Penguin-Lab/cherry/parts/CHERRY_BODY_DOWN.STL

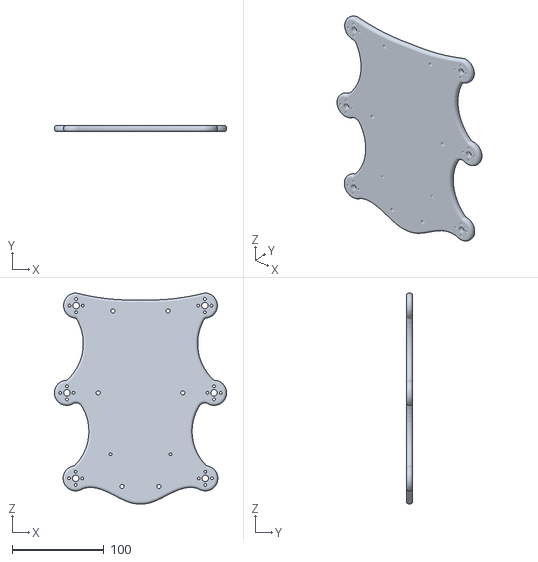
[picture p16: CAD file, 2026-10-26]
parts/CHERRY_BODY_DOWN.STL
187.3 x 7.00 x 229.5
