Penguin-Lab/cherry/parts/CHERRY_FEMUR_BACK_LEFT.STL

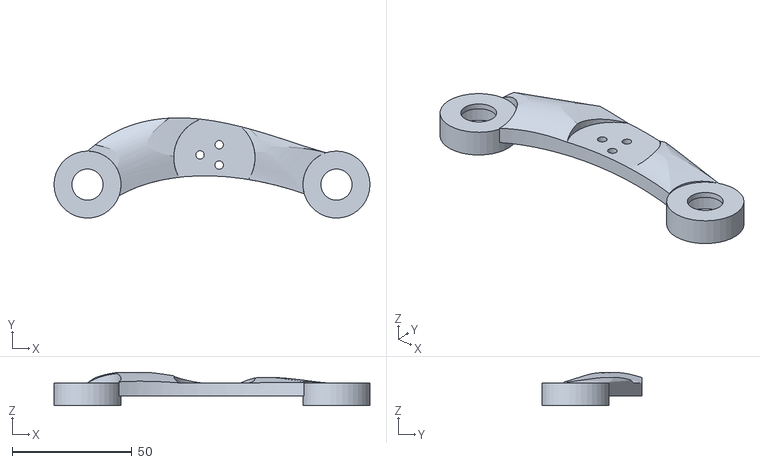
[picture p17: CAD file, 2026-10-26]
parts/CHERRY_FEMUR_BACK_LEFT.STL
132.0 x 41.9 x 13.8
