Penguin-Lab/cherry/parts/CHERRY_BODY_UP.STL

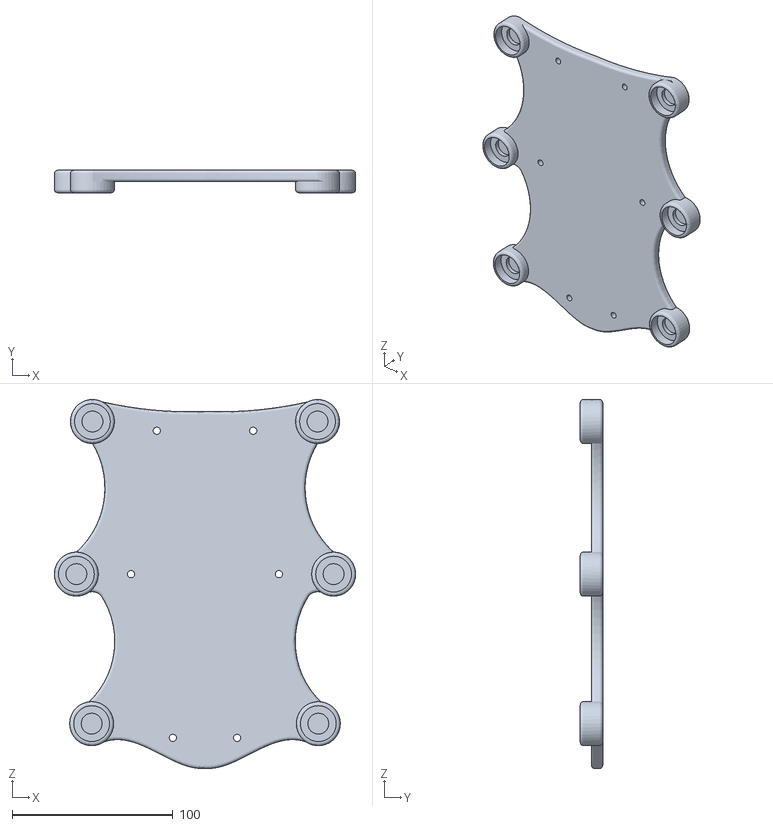
[picture p18: CAD file, 2026-10-26]
parts/CHERRY_BODY_UP.STL
187.4 x 14.0 x 229.5
