Penguin-Lab/cherry/parts/CHERRY_SPACER_CENTER.STL

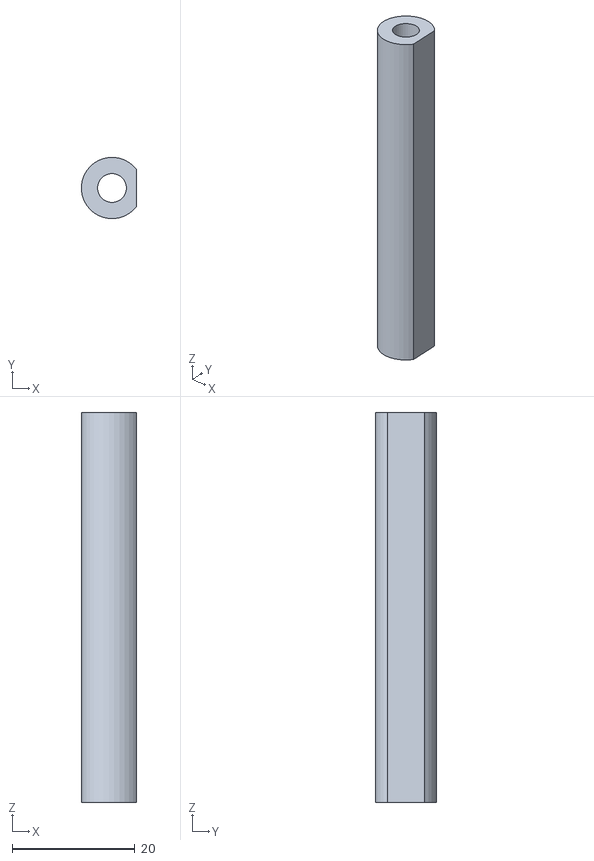
[picture p19: CAD file, 2026-10-26]
parts/CHERRY_SPACER_CENTER.STL
8.98 x 9.98 x 63.6
