Penguin-Lab/cherry/parts/CHERRY_OMBRO_UP_LEFT.STL

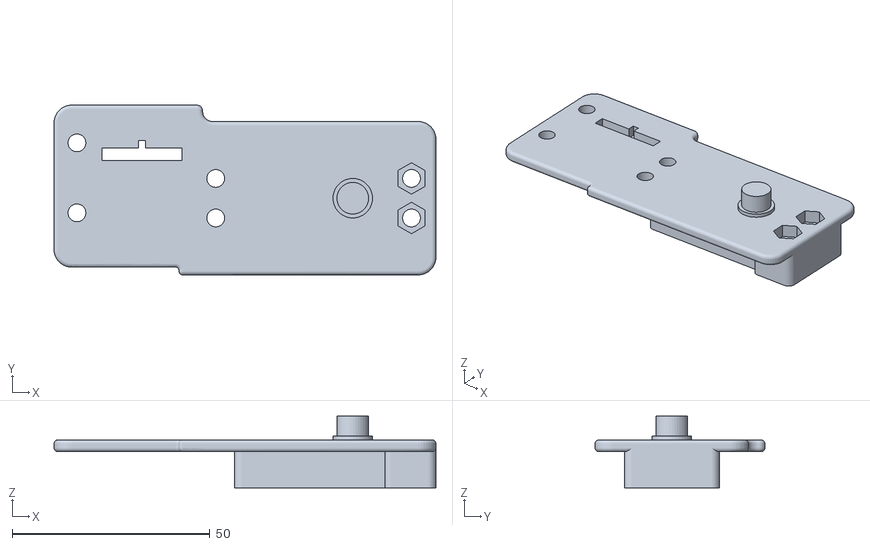
[picture p20: CAD file, 2026-10-26]
parts/CHERRY_OMBRO_UP_LEFT.STL
96.6 x 42.9 x 18.1
