Penguin-Lab/cherry/parts/CHERRY_BODY_UP_LEAVES.STL

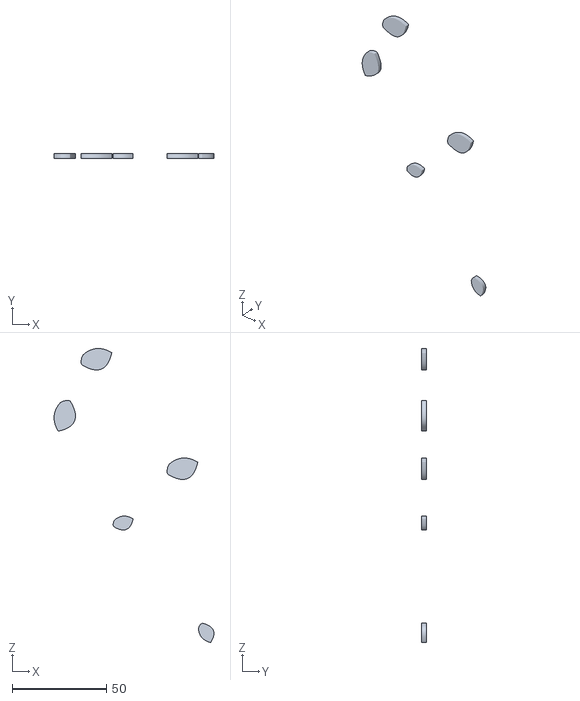
[picture p21: CAD file, 2026-10-26]
parts/CHERRY_BODY_UP_LEAVES.STL
84.8 x 2.50 x 155.8
