Penguin-Lab/cherry/parts/CHERRY_OMBRO_DOWN.STL

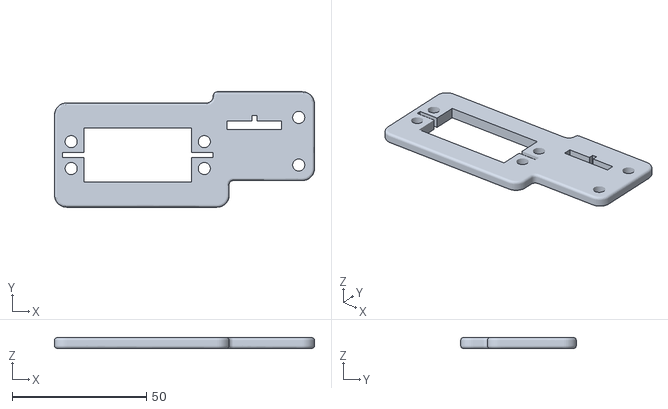
[picture p22: CAD file, 2026-10-26]
parts/CHERRY_OMBRO_DOWN.STL
96.7 x 43.0 x 4.00
