Penguin-Lab/cherry/parts/CHERRY_TIBIA_LEFT.STL

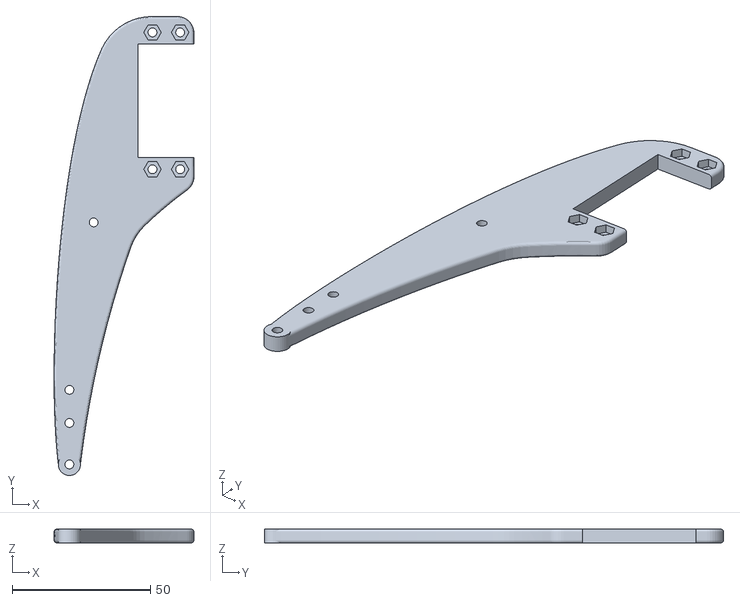
[picture p23: CAD file, 2026-10-26]
parts/CHERRY_TIBIA_LEFT.STL
50.6 x 166.0 x 5.00
