Penguin-Lab/cherry/parts/CHERRY_FEMUR_FRONT_LEFT.STL

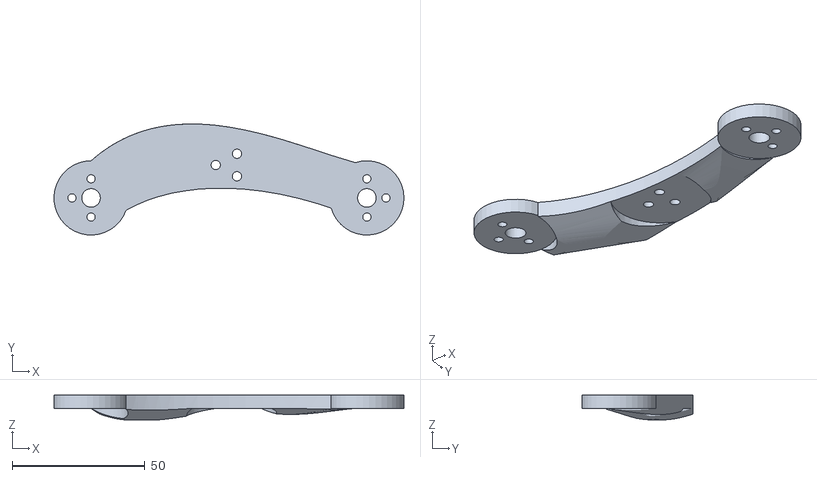
[picture p24: CAD file, 2026-10-26]
parts/CHERRY_FEMUR_FRONT_LEFT.STL
132.0 x 41.9 x 9.34
