Penguin-Lab/cherry/parts/CHERRY_FOOT.STL

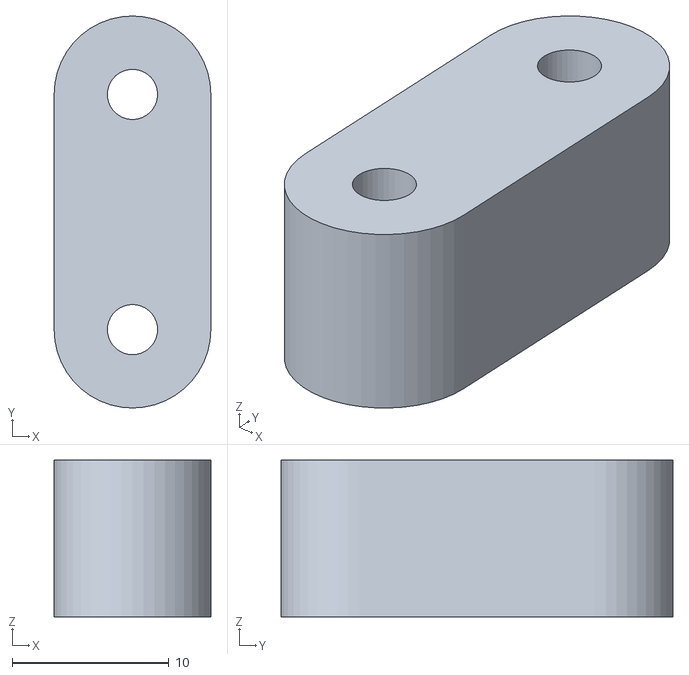
[picture p25: CAD file, 2026-10-26]
parts/CHERRY_FOOT.STL
10.0 x 25.0 x 10.0
