Penguin-Lab/cherry/parts/CHERRY_BODY_UP_BLOSSOMS.STL

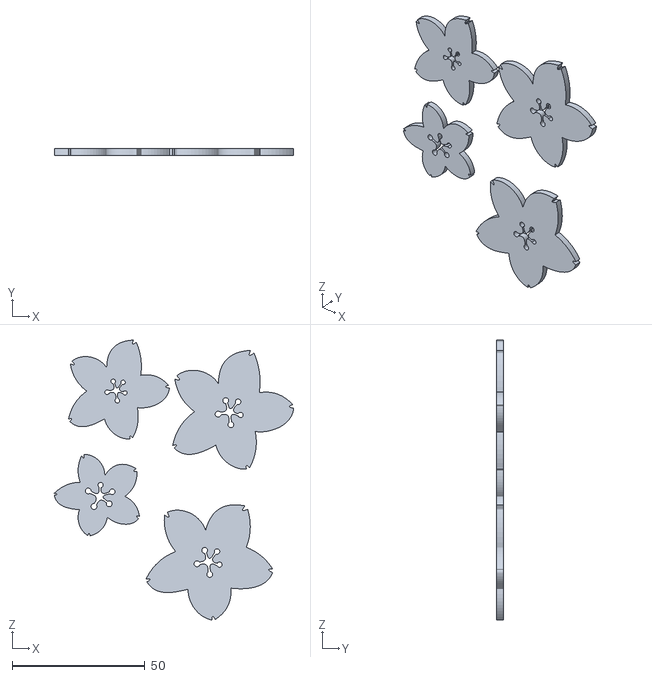
[picture p26: CAD file, 2026-10-26]
parts/CHERRY_BODY_UP_BLOSSOMS.STL
90.2 x 2.50 x 105.5
