Penguin-Lab/cherry/parts/CHERRY_BATTERY_DOOR.STL

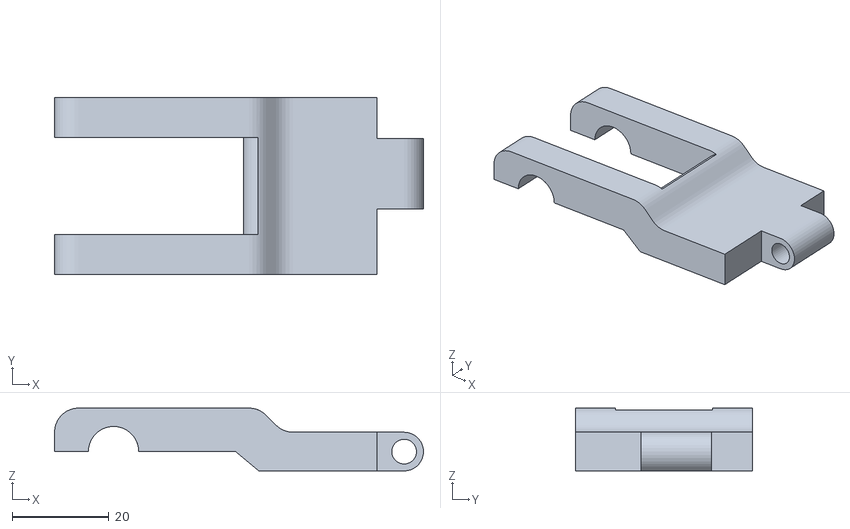
[picture p27: CAD file, 2026-10-26]
parts/CHERRY_BATTERY_DOOR.STL
76.2 x 36.6 x 13.0
