Penguin-Lab/cherry/parts/CHERRY_SHIELD_B_RIGHT.STL

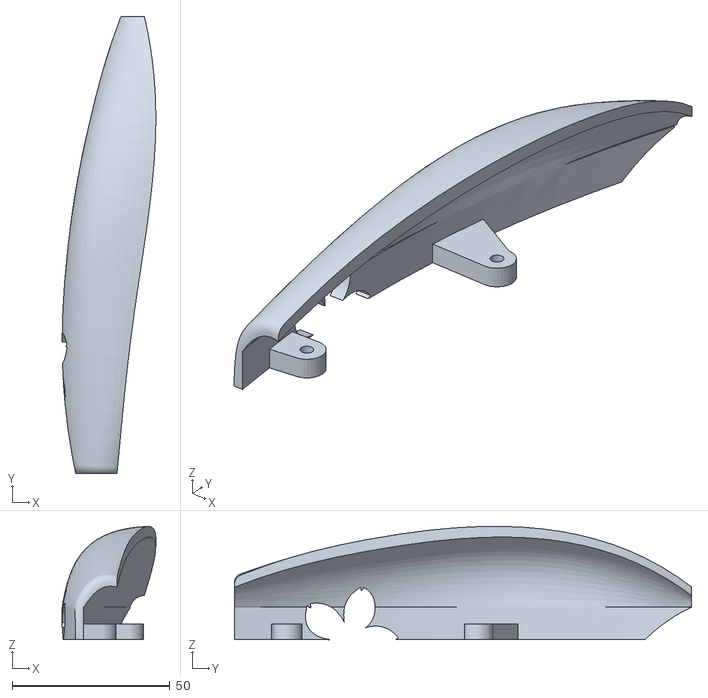
[picture p28: CAD file, 2026-10-26]
parts/CHERRY_SHIELD_B_RIGHT.STL
29.7 x 145.0 x 35.9
