Penguin-Lab/cherry/parts/CHERRY_BODY_UP_BRANCH.STL

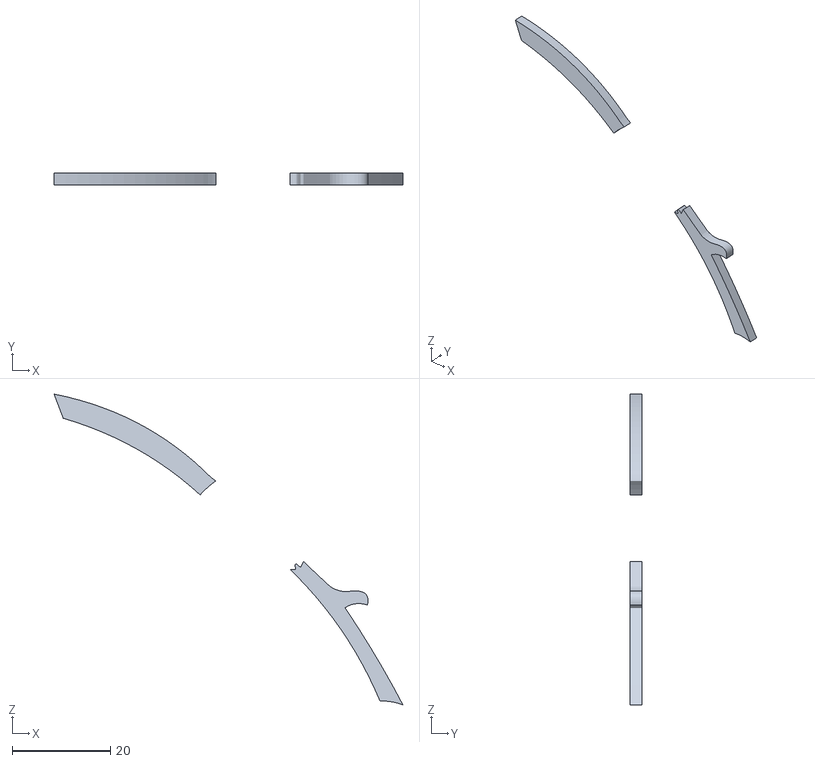
[picture p29: CAD file, 2026-10-26]
parts/CHERRY_BODY_UP_BRANCH.STL
71.1 x 2.50 x 63.4
