Penguin-Lab/cherry/parts/CHERRY_BATTERY_CASE.STL

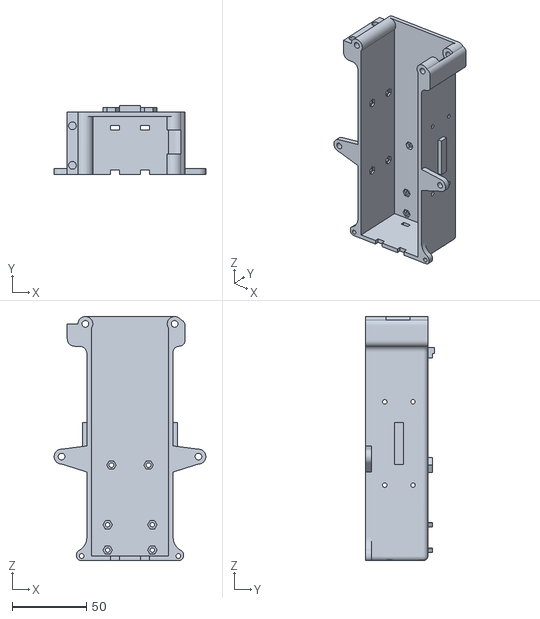
[picture p30: CAD file, 2026-10-26]
parts/CHERRY_BATTERY_CASE.STL
102.0 x 46.5 x 164.0
