Penguin-Lab/cherry/parts/CHERRY_SUPORT_PLUGS_SWITCHES.STL

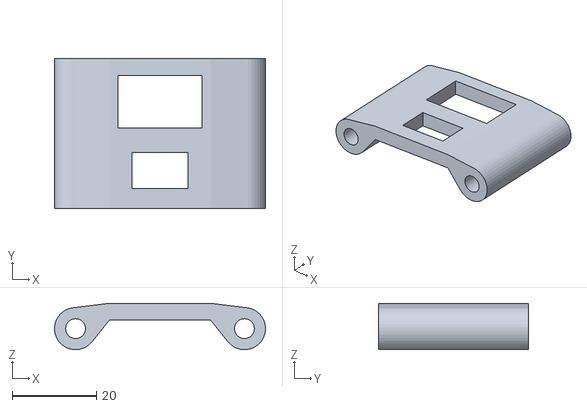
[picture p31: CAD file, 2026-10-26]
parts/CHERRY_SUPORT_PLUGS_SWITCHES.STL
50.0 x 35.5 x 11.0
