Penguin-Lab/cherry/parts/CHERRY_TAMPA_MOTOR_DS3230.STL

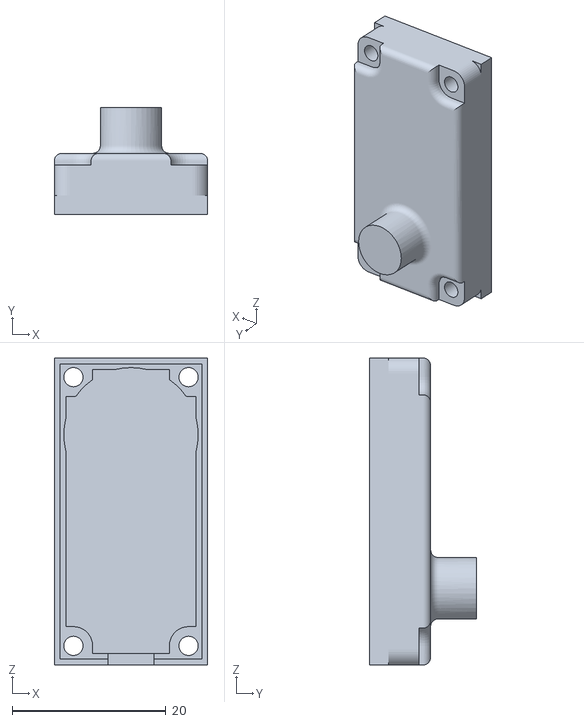
[picture p32: CAD file, 2026-10-26]
parts/CHERRY_TAMPA_MOTOR_DS3230.STL
20.0 x 14.0 x 40.0
