Penguin-Lab/cherry/parts/CHERRY_FEMUR_MIDDLE.STL

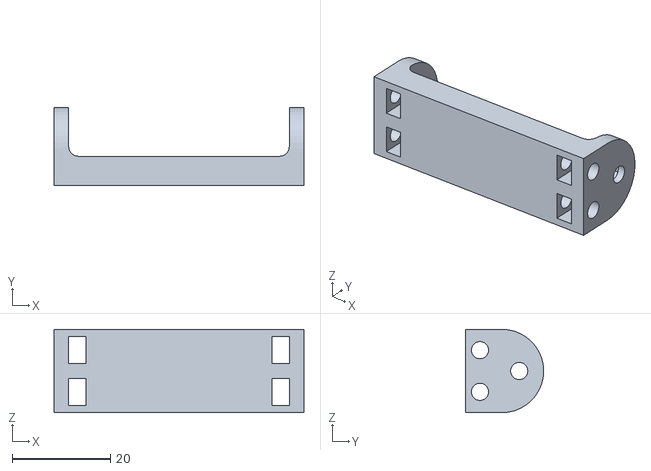
[picture p33: CAD file, 2026-10-26]
parts/CHERRY_FEMUR_MIDDLE.STL
51.0 x 16.0 x 17.0
