Penguin-Lab/cherry/parts/CHERRY_TIBIA_MIDDLE.STL

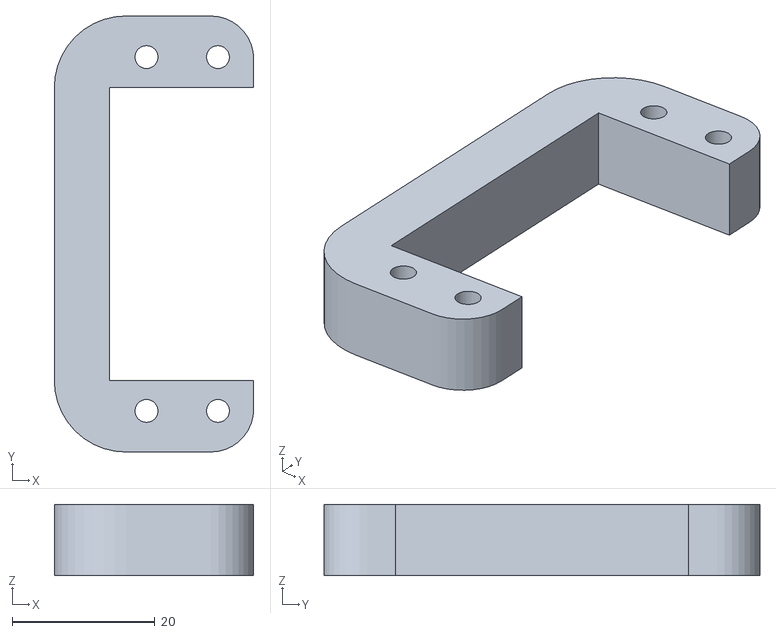
[picture p34: CAD file, 2026-10-26]
parts/CHERRY_TIBIA_MIDDLE.STL
27.9 x 61.0 x 10.0
