Penguin-Lab/cherry/parts/CHERRY_SPACER_FRONT.STL

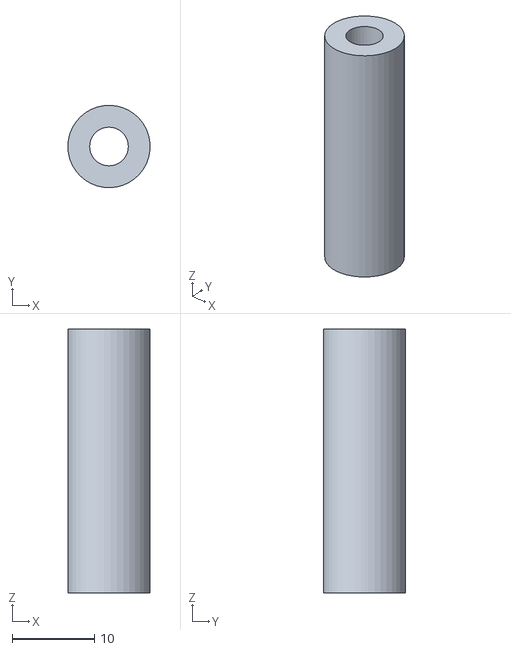
[picture p35: CAD file, 2026-10-26]
parts/CHERRY_SPACER_FRONT.STL
10.0 x 9.99 x 32.0
