Penguin-Lab/cherry/parts/CHERRY_LOGO.STL

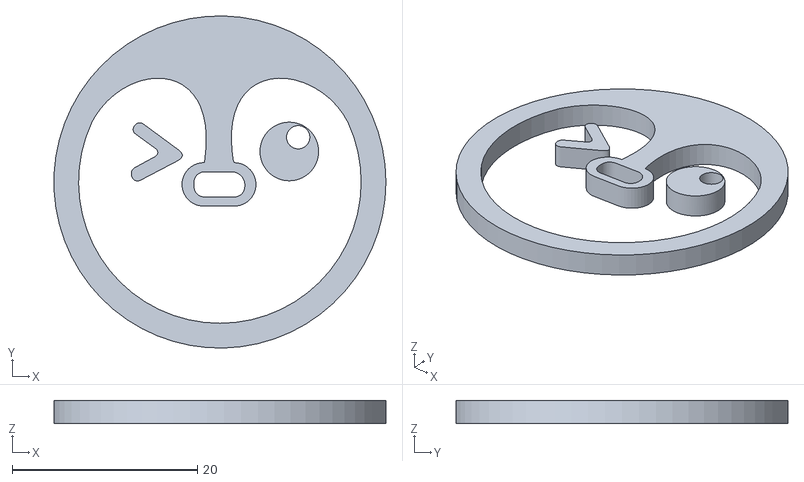
[picture p36: CAD file, 2026-10-26]
parts/CHERRY_LOGO.STL
35.9 x 35.9 x 2.50
