Penguin-Lab/cherry/parts/CHERRY_SUPORT_PLUGS_BATTERY.STL

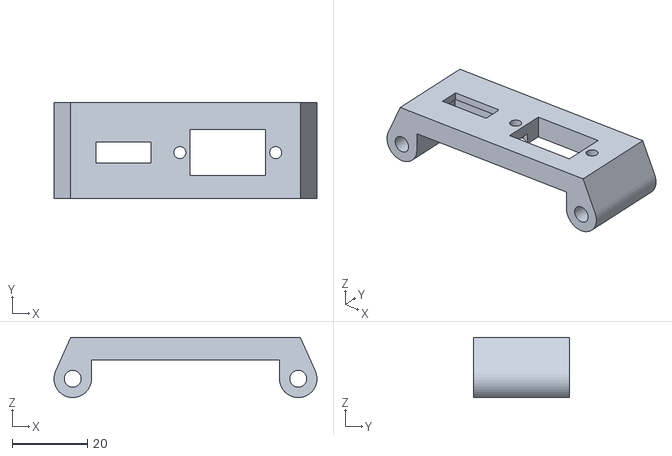
[picture p37: CAD file, 2026-10-26]
parts/CHERRY_SUPORT_PLUGS_BATTERY.STL
70.0 x 25.6 x 16.0
