Penguin-Lab/cherry/(list of files, cad)

Other CAD files:
parts/CHERRY_FEMUR_BACK_RIGHT.STL
parts/CHERRY_FEMUR_FRONT_RIGHT.STL
parts/CHERRY_SHIELD_A_LEFT.STL
parts/CHERRY_TIBIA_RIGHT.STL
parts/CHERRY_SHIELD_B_LEFT.STL
parts/CHERRY_SHIELD_A_RIGHT.STL
parts/CHERRY_OMBRO_UP_RIGHT.STL
