Penguin-Lab/cherry/board/cherry_board_v1.pdf

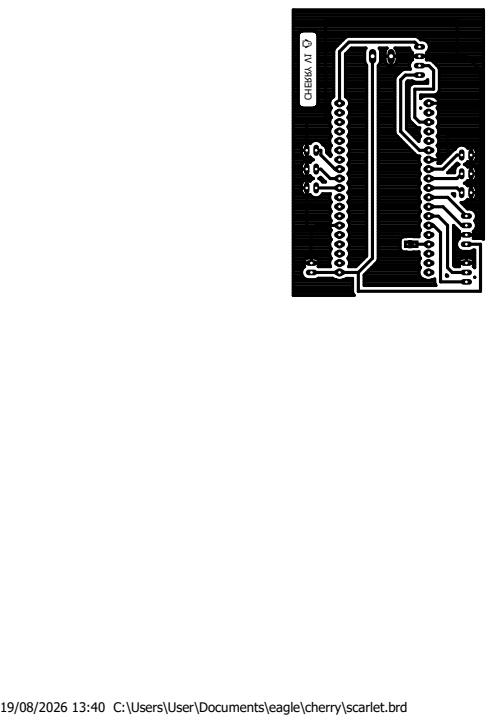
[picture p38: page 1]

19/08/2026 13:40 C:\Users\User\Documents\eagle\cherry\scarlet.brd CHERRY V1
