Penguin-Lab/cherry/board/cherry.brd

## EAGLE design board/cherry.brd (2026-11-01)

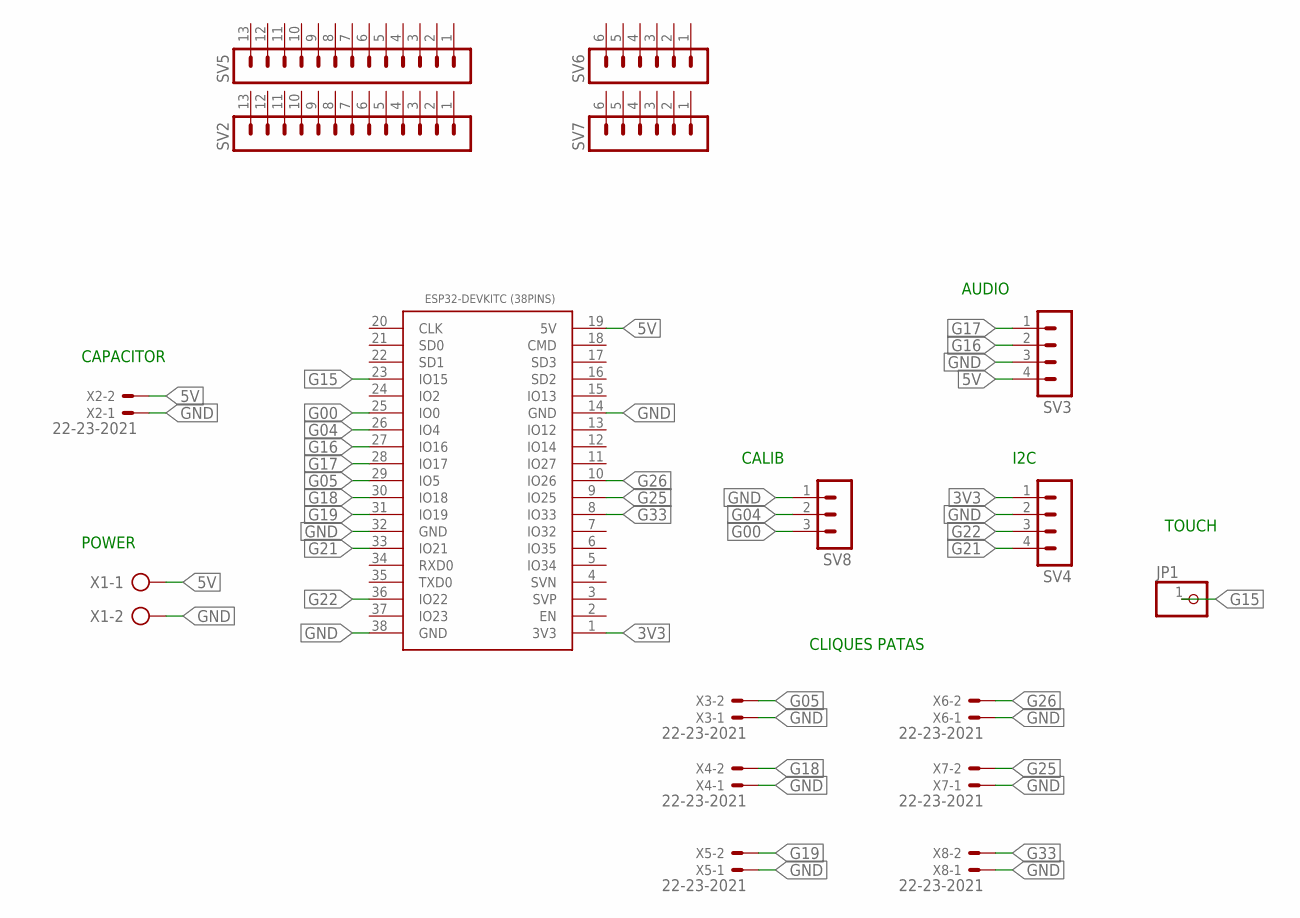
[picture p39: schematic cherry.sch]

Parts:
ESP32-DEVKITC(38PINS)1: ESP32DEVKITC_38PINS; ESP32-DEVKITC
JP1: PINHD-1X1; 1X01
SV2, SV5: MA13-1
SV3, SV4: MA04-1
SV6, SV7: MA06-1
SV8: MA03-1
X1: AK300/2
X2, X3, X4, X5, X6, X7, X8: 22-23-2021

Connections:
3V3: ESP32-DEVKITC(38PINS)1.1 (3V3), SV4.1
5V: ESP32-DEVKITC(38PINS)1.19 (5V), SV3.4, X1.1, X2.2
G00: ESP32-DEVKITC(38PINS)1.25 (IO0), SV8.3
G04: ESP32-DEVKITC(38PINS)1.26 (IO4), SV8.2
G05: ESP32-DEVKITC(38PINS)1.29 (IO5), X3.2
G15: ESP32-DEVKITC(38PINS)1.23 (IO15), JP1.1
G16: ESP32-DEVKITC(38PINS)1.27 (IO16), SV3.2
G17: ESP32-DEVKITC(38PINS)1.28 (IO17), SV3.1
G18: ESP32-DEVKITC(38PINS)1.30 (IO18), X4.2
G19: ESP32-DEVKITC(38PINS)1.31 (IO19), X5.2
G21: ESP32-DEVKITC(38PINS)1.33 (IO21), SV4.4
G22: ESP32-DEVKITC(38PINS)1.36 (IO22), SV4.3
G25: ESP32-DEVKITC(38PINS)1.9 (IO25), X7.2
G26: ESP32-DEVKITC(38PINS)1.10 (IO26), X6.2
G33: ESP32-DEVKITC(38PINS)1.8 (IO33), X8.2
GND: ESP32-DEVKITC(38PINS)1.14 (GND), ESP32-DEVKITC(38PINS)1.32 (GND), ESP32-DEVKITC(38PINS)1.38 (GND), SV3.3, SV4.2, SV8.1, X1.2, X2.1, X3.1, X4.1, X5.1, X6.1, X7.1, X8.1

Notes on the sheet:
CAPACITOR
POWER
I2C
AUDIO
CALIB
CLIQUES PATAS
TOUCH

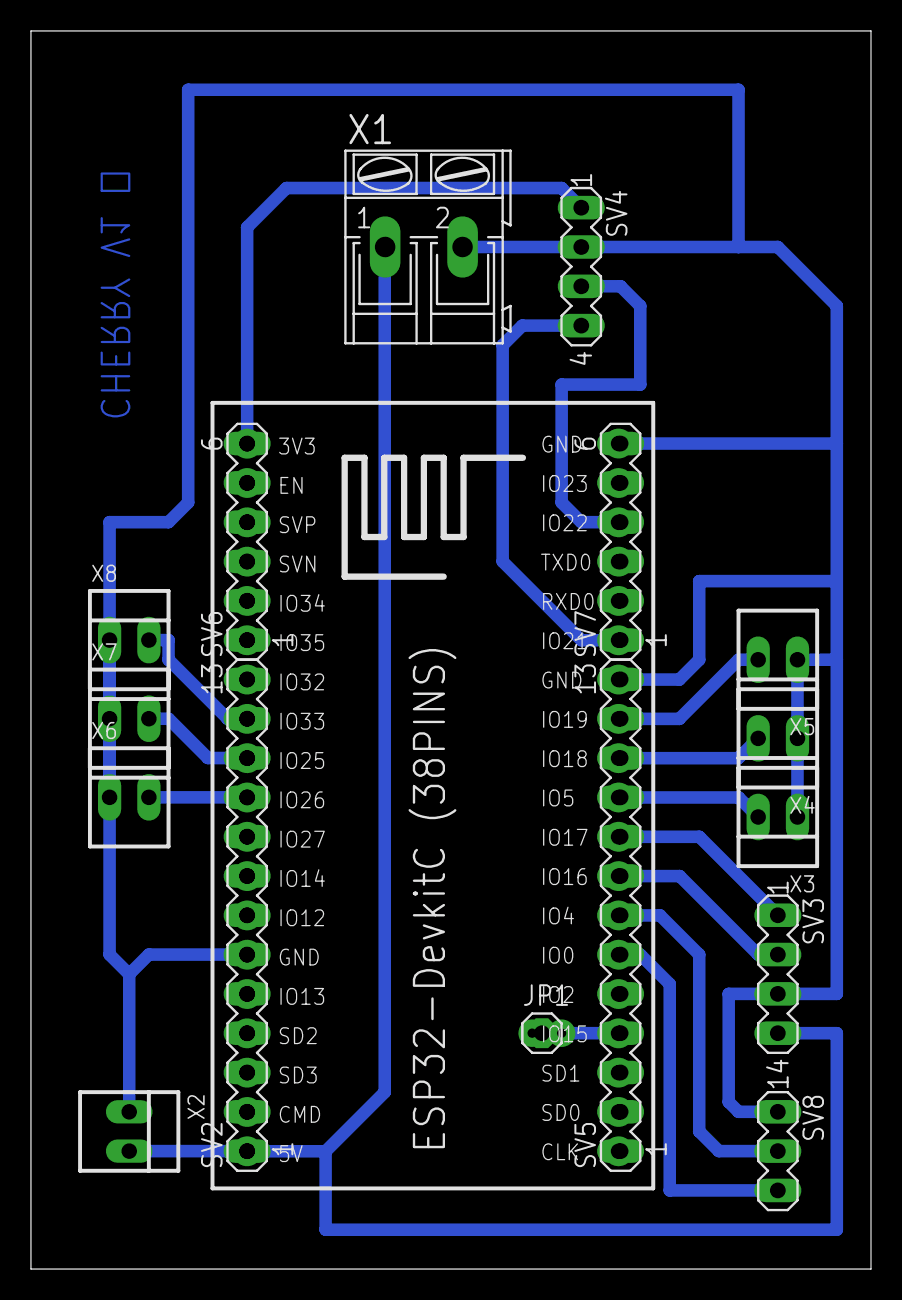
[picture p40: board cherry.brd from above]

Board: 2 copper layers, 54.3 x 80.0 mm, 17 parts (0 on the bottom side), 16 nets.
